cgoettel/frankenbear/README.md

# frankenbear

## Wiring
### Raspberry Pi connection
Connect the GPIO pins on the Raspberry Pi to the Arduino):
- GND (pin 6) &rarr; GND
- GPIO14 (pin 8) &rarr; 0
- GPIO15 (pin 10) &rarr; 1
