cgoettel/frankenbear/(commit log)

2015-03-10 Worked with temperature sensor.
    I don't think it's going to work. Going to probably have to use an IR proximity sensor.
2015-03-12 Got sound working. Figured out big servos are busted.
2015-03-27 Added proximity sensor code. Cleaned up code. Put header info in sections.
2015-03-31 Added circuitry schematic.
2015-04-08 Added DEBUG for Serial printing.
2015-04-09 Added UART with RPi. Added multiple songs via UART.
